abrahamayorinde/DRONE/images/4x1_esc.jpg

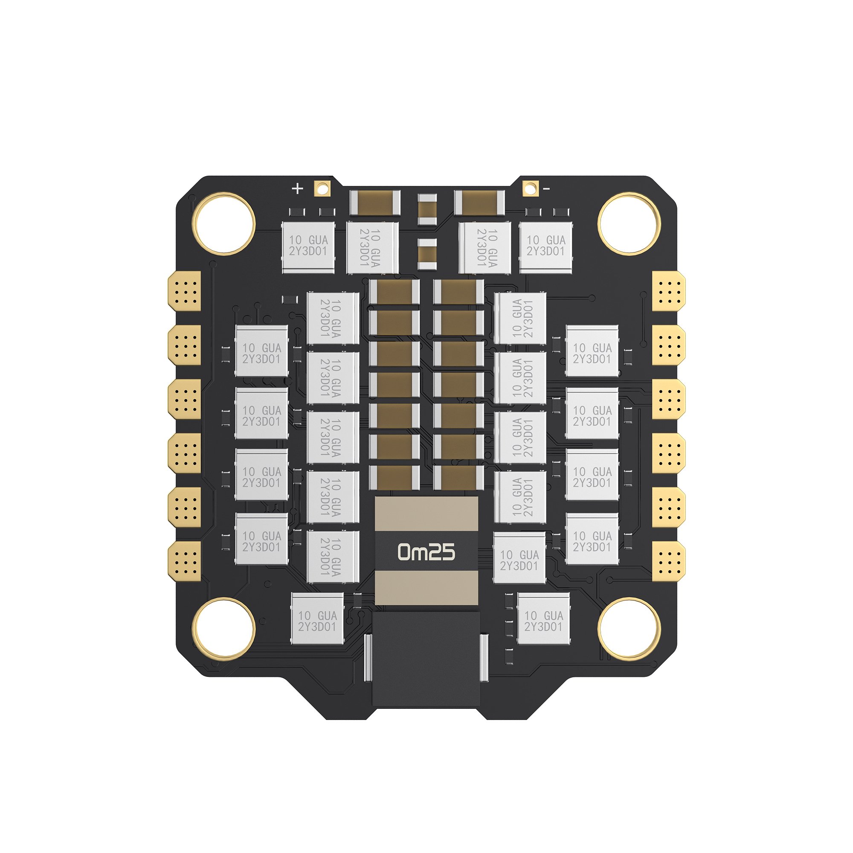
images/4x1_esc.jpg
