abrahamayorinde/DRONE/images/12v_battery.jpg

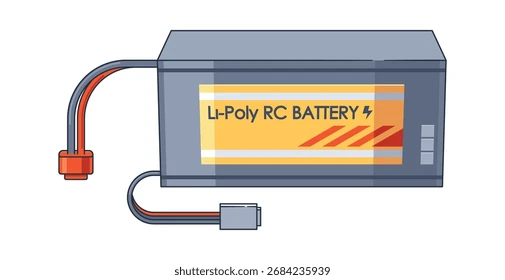
images/12v_battery.jpg
