abrahamayorinde/DRONE/images/60A_Brushless_ESC.webp

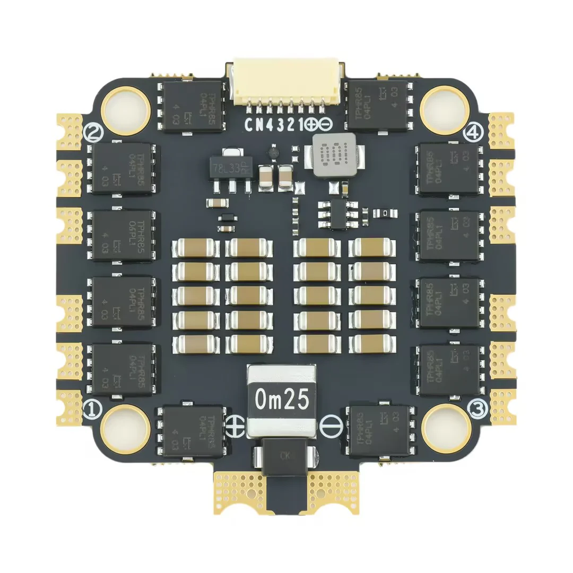
images/60A_Brushless_ESC.webp
