abrahamayorinde/DRONE/images/capacitor.webp

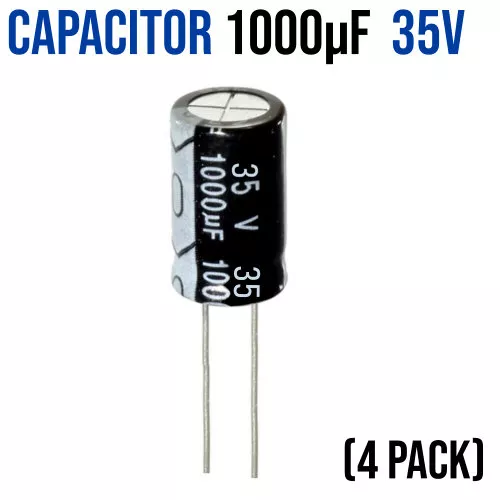
images/capacitor.webp
