abrahamayorinde/DRONE/images/dc_motor.jpg

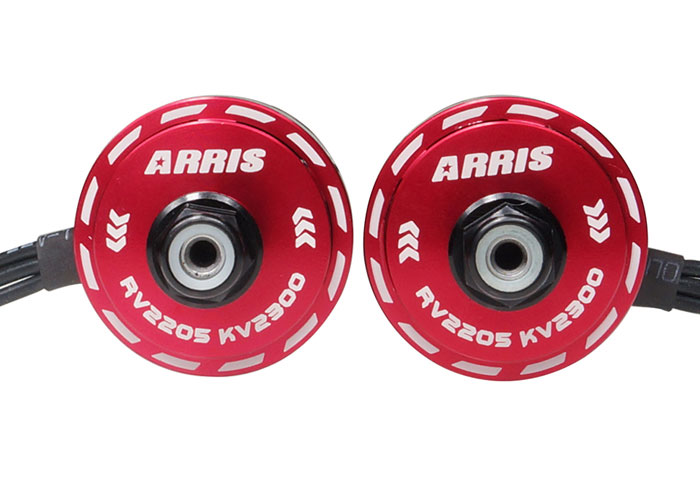
images/dc_motor.jpg
