abrahamayorinde/DRONE/images/fsia6_receiver.webp

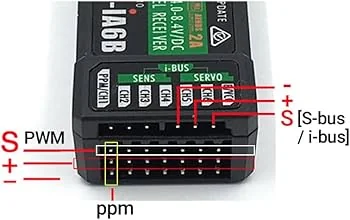
images/fsia6_receiver.webp
