abrahamayorinde/DRONE/images/MP1584EN_buck.jpg

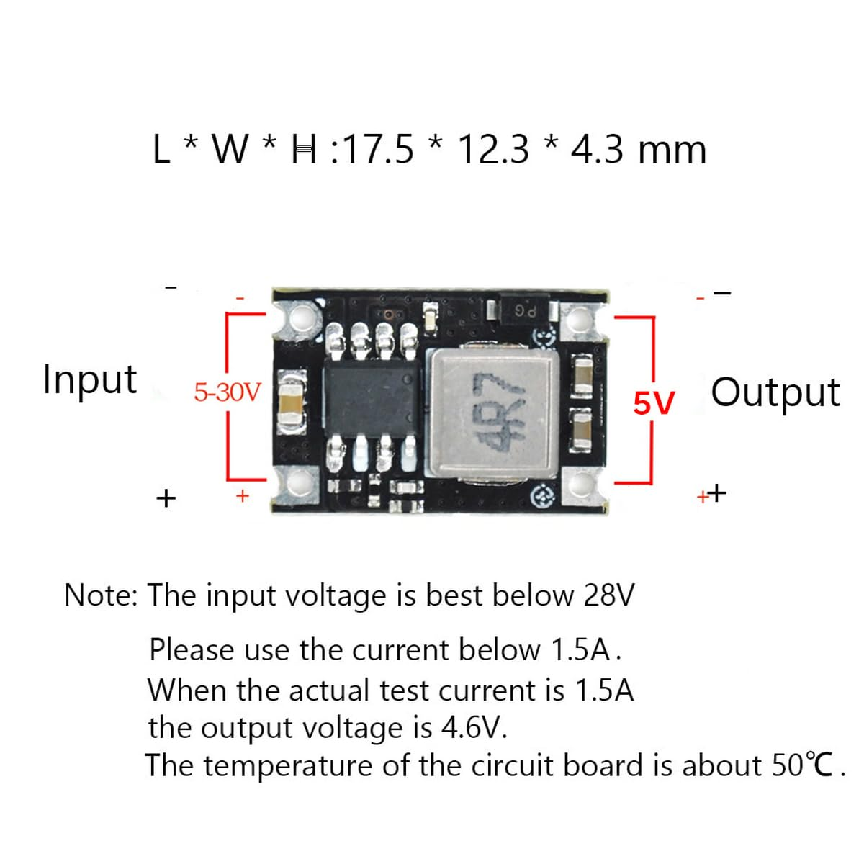
images/MP1584EN_buck.jpg
