abrahamayorinde/DRONE/images/mpu6050.png

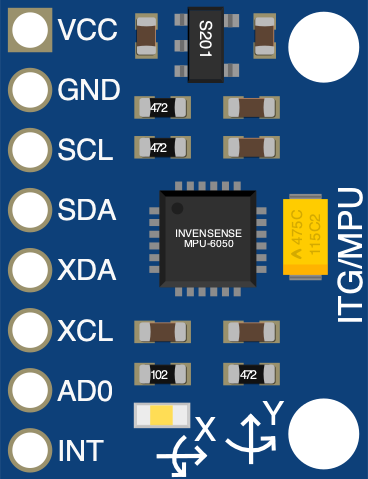
images/mpu6050.png
