abrahamayorinde/DRONE/images/teensy_4_0.jpg

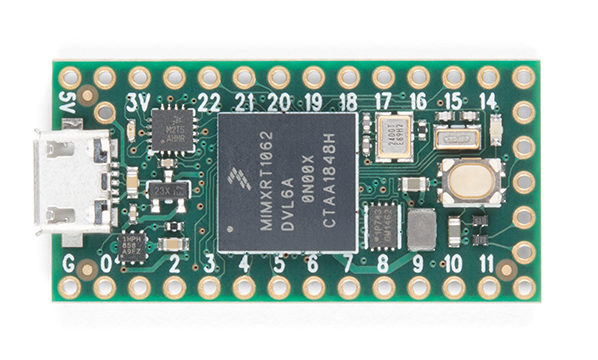
images/teensy_4_0.jpg
