abrahamayorinde/DRONE/images/Component_Interconnect_Drawing.pdf

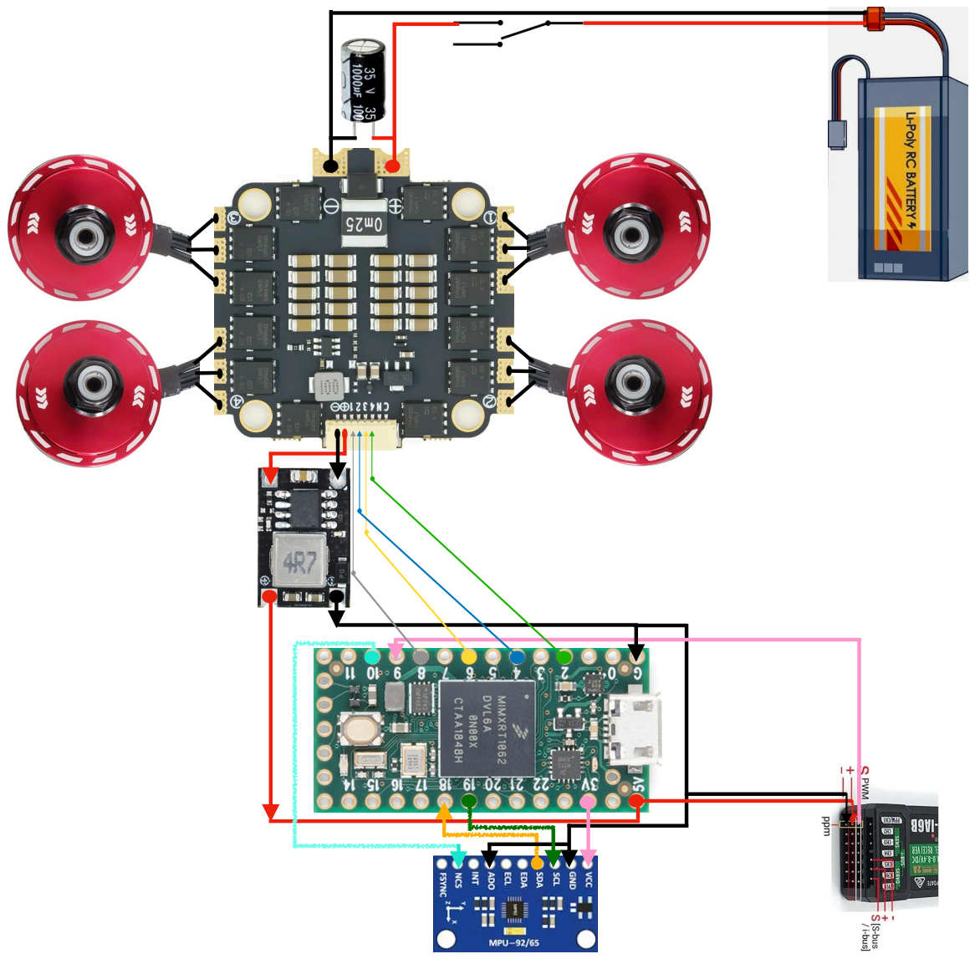
[picture p13: page 1]
