abrahamayorinde/DRONE/src/Classes/IMU/mpu92_65_constants.h

#ifndef MPU92_65_CONSTANTS_H
#define MPU92_65_CONSTANTS_H

#include <cstdint>
#include <stdint.h>

const float ax_min = -2023;// -7980;//-8192;
const float ax_max =  2048;//  8390;//8192;

const float ay_min = -2043;// -8360;//-8192;
const float ay_max =  2055;//  8000;//8192;

const float az_min = -2048;// -8900;//16384;
const float az_max =  2092;// 7650;//24576;

const float_t ax_offset = (ax_min + ax_max)/2;
const float_t ay_offset = (ay_min + ay_max)/2;
const float_t az_offset = (az_min + az_max)/2;
const float_t x_scale = 2/(ax_max - ax_min);
const float_t y_scale = 2/(ay_max - ay_min);
const float_t z_scale = 2/(az_max - az_min);

const float GYRO_RESOLUTION = 16.375;//65.5; //degrees per second per count
const uint8_t interruptPin = 9;//11;


constexpr float IMU_FILTER_ACCEL = 0.14;//0.003045902795; /* Equation for filter at loop rate of .001 or 1/1000 =>(1/1000)/( ( 1/(2*PI*10) ) + (1/1000) )*/
constexpr float IMU_FILTER_GYRO = 0.1;

const float maxRoll = 30.0;
const float maxPitch = 30.0;
const float maxYaw = 160.0;

const double IMU_CALIBRATION_COUNT = 1000;

const float PITCH_RATE_MAX = 240;
const float PITCH_RATE_MIN = -240;

const float ROLL_RATE_MAX = 240;
const float ROLL_RATE_MIN = -240;

#endif //MPU92_65_CONSTANTS_H
