abrahamayorinde/DRONE/src/Classes/IMU/mpu92_65.h

#ifndef MPU92_65_H
#define MPU92_65_H

#include "SPI.h"
#include "mpu6500.h"
#include "mpu92_65_constants.h"



class MPU_92_65
{
    private:
    bfs::Mpu6500 imu;
    public:
    MPU_92_65();
    void checkIMUSPISensor();
    void calibrateGyro();
    void getSensorData();
    float gx_offset, gy_offset, gz_offset;
    float GyroX_Filt, GyroY_Filt, GyroZ_Filt;
    float GyroX, GyroY, GyroZ;
    float AccX_Filt, AccY_Filt, AccZ_Filt;
    float AccX, AccY, AccZ;
};



#endif // MPU92_65_H
