abrahamayorinde/DRONE/(commit log)

2026-01-03 Created a class for the IMU sensor.
2026-01-28 interrupt mode adjust pid gain
2026-01-28 no need to run the 1msec interrupt routine as much
2026-02-05 Update readme with drone control mechanisms
    Removed several component listings from the readme and added detailed explanations of drone control mechanisms including elevation, yaw, pitch, and roll.
2026-02-05 add drone prop orientation image.
2026-03-03 Clean up debug prints and remove loopRate function
    Removed unnecessary debug print statements and a commented-out loop rate function to clean up the code.
